WojtaCZ/repeat-hw/README.md

# REPEAT-HW

A repository containing hardware files (KiCad project) for the REPEAT board
