WojtaCZ/repeat-hw/repeat-hw.kicad_pcb

## KiCad design repeat-hw.kicad_pcb (2023-11-19)

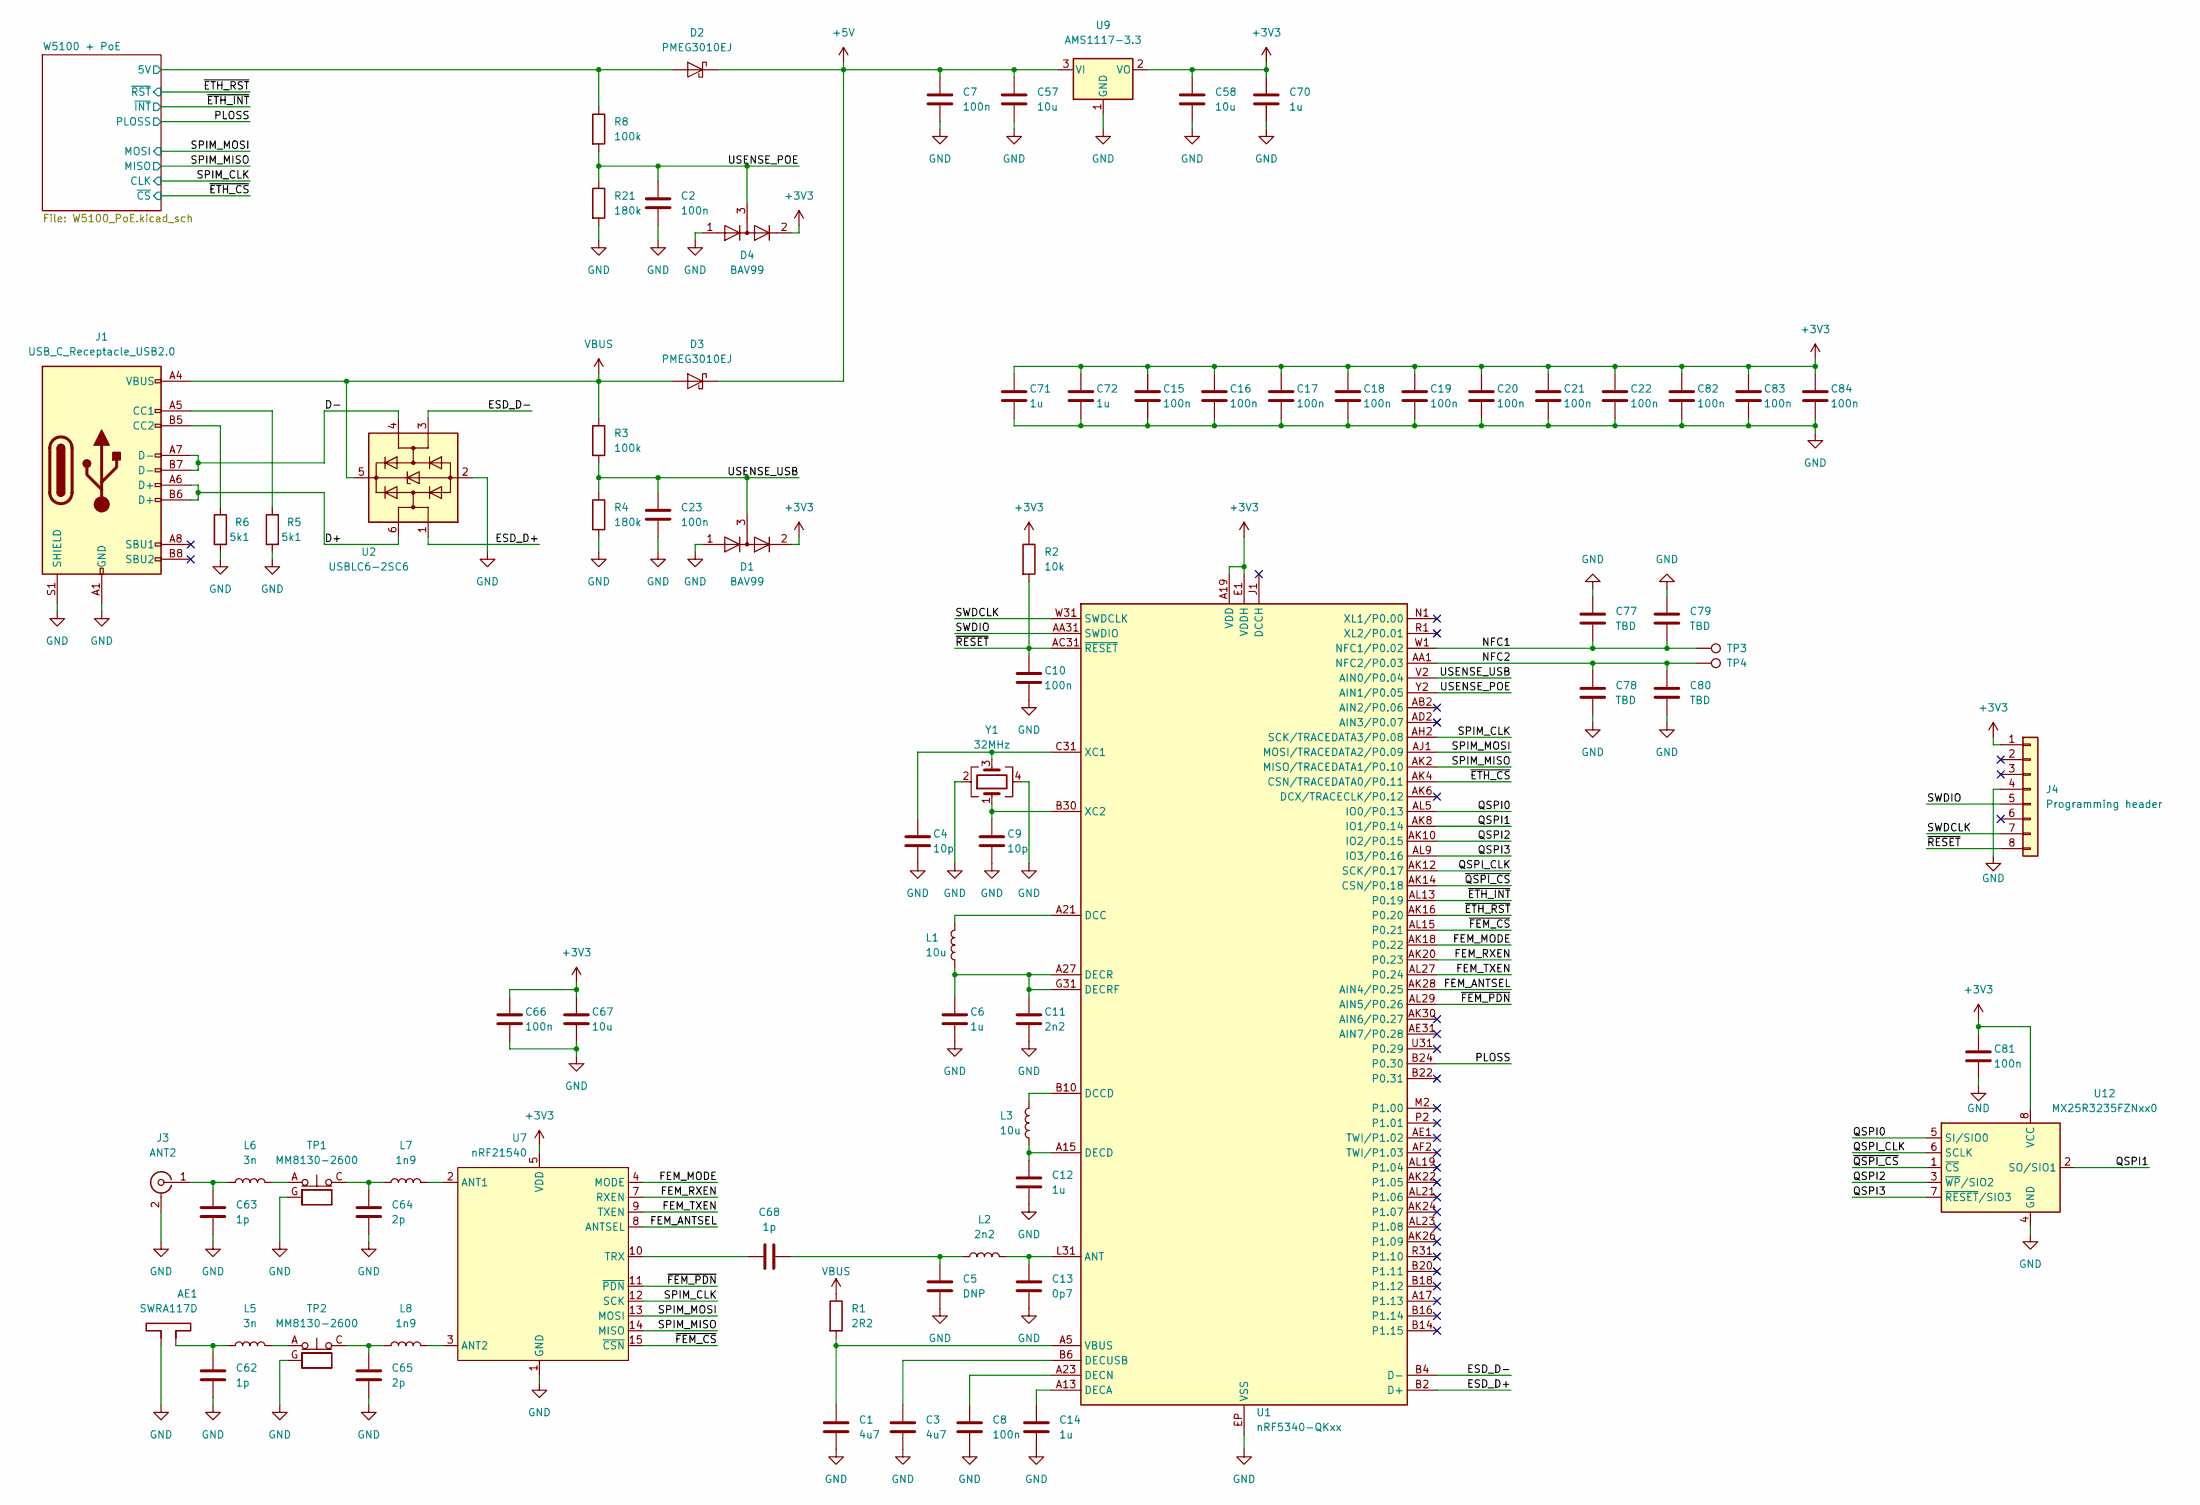
[picture p1: schematic repeat-hw.kicad_sch]

Parts:
AE1: SWRA117D; Texas_SWRA117D_2.4GHz_Right
C1, C3: 4u7; C_0603_1608Metric
C2, C7, C8, C10, C15, C16, C17, C18, C19, C20, C21, C22, C23, C66, C81, C82, C83, C84: 100n; C_0402_1005Metric
C4, C9: 10p; C_0402_1005Metric
C5: DNP; C_0402_1005Metric
C6, C12, C14, C70, C71, C72: 1u; C_0603_1608Metric
C11: 2n2; C_0402_1005Metric
C13: 0p7; C_0402_1005Metric
C57, C58: 10u; C_0603_1608Metric
C62, C63, C68: 1p; C_0402_1005Metric
C64, C65: 2p; C_0402_1005Metric
C67: 10u; C_0402_1005Metric
C77, C78, C79, C80: TBD; C_0402_1005Metric
D1, D4: BAV99; SOT-23
D2, D3: PMEG3010EJ; D_SOD-323F
J1: USB_C_Receptacle_USB2.0; USB_C_Receptacle_XKB_U262-16XN-4BVC11
J3: ANT2; U.FL_Hirose_U.FL-R-SMT-1_Vertical
J4: Programming header; SOIC_clipProgSmall
L1, L3: 10u; L_0603_1608Metric
L2: 2n2; C_0402_1005Metric
L5, L6: 3n; C_0402_1005Metric
L7, L8: 1n9; C_0402_1005Metric
R1: 2R2; R_0402_1005Metric
R2: 10k; R_0402_1005Metric
R3, R8: 100k; R_0402_1005Metric
R4, R21: 180k; R_0402_1005Metric
R5, R6: 5k1; R_0402_1005Metric
TP1, TP2: MM8130-2600
TP3, TP4: TestPoint; TestPoint_Pad_D1.0mm
U1: nRF5340-QKxx; Nordic_AQFN-94-1EP_7x7mm_P0.4mm
U2: USBLC6-2SC6; SOT-23-6
U7: nRF21540; QFN-16-1EP_4x4mm_P0.65mm_EP2.7x2.7mm_ThermalVias
U9: AMS1117-3.3; SOT-223-3_TabPin2
U12: MX25R3235FZNxx0; WSON-8-1EP_6x5mm_P1.27mm_EP3.4x4mm
Y1: 32MHz; Crystal_SMD_3225-4Pin_3.2x2.5mm

Connections:
+3V3: C15.1, C16.1, C17.1, C18.1, C19.1, C20.1, C21.1, C22.1, C58.1, C66.1, C67.1, C70.1, C71.1, C72.1, C81.1, C82.1, C83.1, C84.1, D1.2 (A), D4.2 (A), J4.1, R2.1, U1.A19 (VDD), U1.AC1 (VDD), U1.AG1 (VDD), U1.AJ31 (VDD), U1.AL3 (VDD), U1.AL7 (VDD), U1.AL11 (VDD), U1.AL17 (VDD), U1.AL25 (VDD), U1.B8 (VDD), U1.B28 (VDD), U1.C1 (VDD), U1.E1 (VDDH), U1.E31 (VDD), U1.L1 (VDD), U1.N31 (VDD), U1.U1 (VDD), U7.5 (VDD), U7.6 (VDD), U9.2 (VO), U12.8 (VCC); also elsewhere on the board
+5V: C7.1, C57.1, D2.1 (K), D3.1 (K), U9.3 (VI)
/D+: J1.A6 (D+), J1.B6 (D+), U2.6 (I/O1)
/D-: J1.A7 (D-), J1.B7 (D-), U2.4 (I/O2)
/ESD_D+: U1.B2 (D+), U2.1 (I/O1)
/ESD_D-: U1.B4 (D-), U2.3 (I/O2)
/FEM_ANTSEL: U1.AK28 (AIN4/P0.25), U7.8 (ANTSEL)
/FEM_MODE: U1.AK18 (P0.22), U7.4 (MODE)
/FEM_RXEN: U1.AK20 (P0.23), U7.7 (RXEN)
/FEM_TXEN: U1.AL27 (P0.24), U7.9 (TXEN)
/NFC1: C77.2, C79.2, TP3.1, U1.W1 (NFC1/P0.02)
/NFC2: C78.1, C80.1, TP4.1, U1.AA1 (NFC2/P0.03)
/PLOSS: U1.B24 (P0.30); also elsewhere on the board
/QSPI0: U1.AL5 (IO0/P0.13), U12.5 (SI/SIO0)
/QSPI1: U1.AK8 (IO1/P0.14), U12.2 (SO/SIO1)
/QSPI2: U1.AK10 (IO2/P0.15), U12.3 (~WP/SIO2)
/QSPI3: U1.AL9 (IO3/P0.16), U12.7 (~RESET/SIO3)
/QSPI_CLK: U1.AK12 (SCK/P0.17), U12.6 (SCLK)
/SPIM_CLK: U1.AH2 (SCK/TRACEDATA3/P0.08), U7.12 (SCK); also elsewhere on the board
/SPIM_MISO: U1.AK2 (MISO/TRACEDATA1/P0.10), U7.14 (MISO); also elsewhere on the board
/SPIM_MOSI: U1.AJ1 (MOSI/TRACEDATA2/P0.09), U7.13 (MOSI); also elsewhere on the board
/SWDCLK: J4.7, U1.W31 (SWDCLK)
/SWDIO: J4.5, U1.AA31 (SWDIO)
/USENSE_POE: C2.1, D4.3 (K), R8.2, R21.1, U1.Y2 (AIN1/P0.05)
/USENSE_USB: C23.1, D1.3 (K), R3.2, R4.1, U1.V2 (AIN0/P0.04)
/W5100 + PoE/5V: D2.2 (A), R8.1; also elsewhere on the board
/~ETH_CS: U1.AK4 (CSN/TRACEDATA0/P0.11); also elsewhere on the board
/~ETH_INT: U1.AL13 (P0.19); also elsewhere on the board
/~ETH_RST: U1.AK16 (P0.20); also elsewhere on the board
/~FEM_CS: U1.AL15 (P0.21), U7.15 (~CSN)
/~FEM_PDN: U1.AL29 (AIN5/P0.26), U7.11 (~PDN)
/~QSPI_CS: U1.AK14 (CSN/P0.18), U12.1 (~CS)
/~RESET: C10.1, J4.8, R2.2, U1.AC31 (~RESET)
GND: AE1.2, C1.2, C2.2, C3.2, C4.2, C5.2, C6.2, C7.2, C8.2, C9.2, C10.2, C11.2, C12.2, C13.2, C14.2, C15.2, C16.2, C17.2, C18.2, C19.2, C20.2, C21.2, C22.2, C23.2, C57.2, C58.2, C62.2, C63.2, C64.2, C65.2, C66.2, C67.2, C70.2, C71.2, C72.2, C77.1, C78.2, C79.1, C80.2, C81.2, C82.2, C83.2, C84.2, D1.1 (K), D4.1 (K), J1.A1 (GND), J1.A12 (GND), J1.B1 (GND), J1.B12 (GND), J1.S1 (SHIELD), J3.2 (Ext), J4.4, R4.2, R5.2, R6.2, R21.2, TP1.G, TP2.G, U1.EP (VSS), U2.2 (GND), U7.1 (GND), U7.16 (GND), U7.17 (GND), U9.1 (GND), U12.4 (GND), U12.9 (GND), Y1.2, Y1.4; also elsewhere on the board
unnamed: AE1.1, C62.1, L5.1
unnamed: C1.1, R1.2, U1.A5 (VBUS)
unnamed: C3.1, U1.B6 (DECUSB)
unnamed: C4.1, U1.C31 (XC1), Y1.3
unnamed: C5.1, C68.2, L2.1
unnamed: C8.1, U1.A23 (DECN)
unnamed: C9.1, U1.B30 (XC2), Y1.1
unnamed: C6.1, C11.1, L1.1, U1.A27 (DECR), U1.G31 (DECRF)
unnamed: C12.1, L3.1, U1.A15 (DECD)
unnamed: C13.1, L2.2, U1.L31 (ANT)
unnamed: C14.1, U1.A13 (DECA)
unnamed: C63.1, J3.1 (In), L6.1
unnamed: C64.1, L7.1, TP1.C
unnamed: C65.1, L8.1, TP2.C
unnamed: C68.1, U7.10 (TRX)
unnamed: J1.A5 (CC1), R5.1
unnamed: J1.B5 (CC2), R6.1
unnamed: L1.2, U1.A21 (DCC)
unnamed: L3.2, U1.B10 (DCCD)
unnamed: L5.2, TP2.A
unnamed: L6.2, TP1.A
unnamed: L7.2, U7.2 (ANT1)
unnamed: L8.2, U7.3 (ANT2)
VBUS: D3.2 (A), J1.A4 (VBUS), J1.A9 (VBUS), J1.B4 (VBUS), J1.B9 (VBUS), R1.1, R3.1, U2.5 (VBUS)

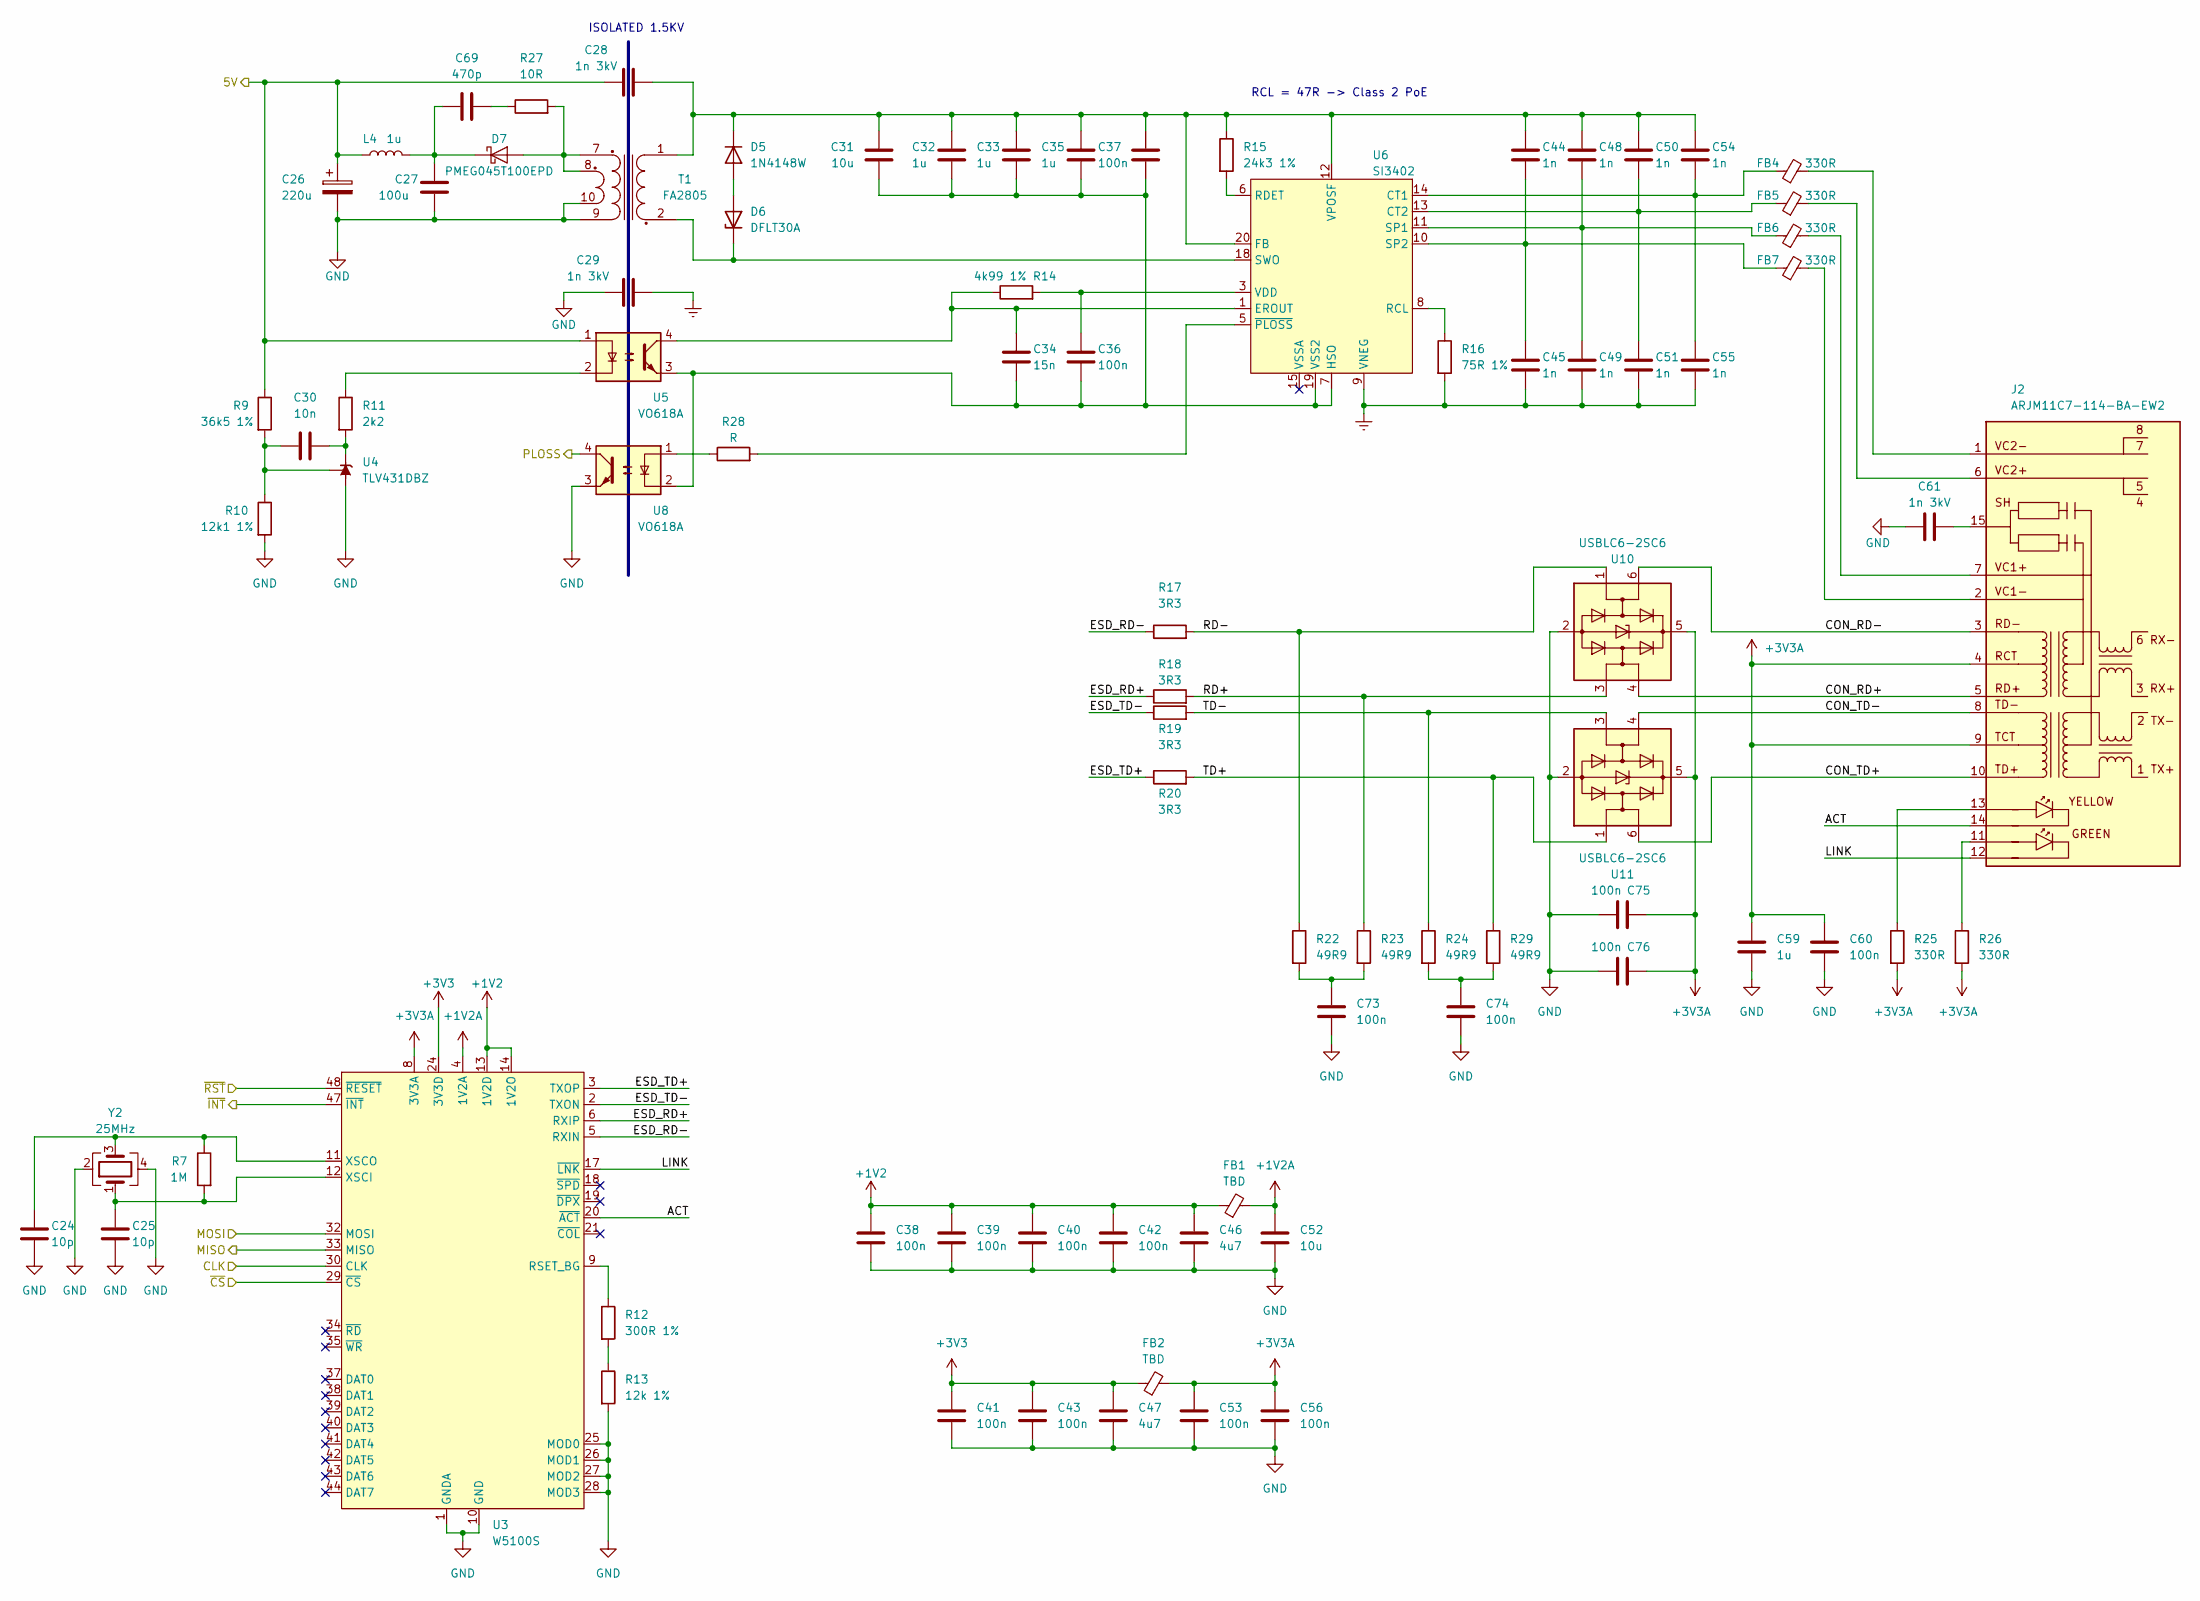
[picture p2: schematic W5100_PoE.kicad_sch]

Parts:
C24, C25: 10p; C_0402_1005Metric
C26: 220u; CP_Elec_5x5.3
C27: 100u; C_1206_3216Metric
C28, C29, C61: 1n 3kV; C_1206_3216Metric
C30: 10n; C_0402_1005Metric
C31, C52: 10u; C_0603_1608Metric
C32, C33, C35, C59: 1u; C_0603_1608Metric
C34: 15n; C_0402_1005Metric
C36, C37, C38, C39, C40, C41, C42, C43, C53, C56, C60, C73, C74, C75, C76: 100n; C_0402_1005Metric
C44, C45, C48, C49, C50, C51, C54, C55: 1n; C_0402_1005Metric
C46, C47: 4u7; C_0603_1608Metric
C69: 470p; C_0402_1005Metric
D5: 1N4148W; D_SOD-123
D6: DFLT30A; D_PowerDI-123
D7: PMEG045T100EPD; Nexperia_CFP15_SOT-1289
FB1, FB2: TBD; C_0402_1005Metric
FB4, FB5, FB6, FB7: 330R; L_0805_2012Metric
J2: ARJM11C7-114-BA-EW2
L4: 1u; C_0603_1608Metric
R7: 1M; R_0402_1005Metric
R9: 36k5 1%; R_0402_1005Metric
R10: 12k1 1%; R_0402_1005Metric
R11: 2k2; R_0402_1005Metric
R12: 300R 1%; R_0402_1005Metric
R13: 12k 1%; R_0402_1005Metric
R14: 4k99 1%; R_0402_1005Metric
R15: 24k3 1%; R_0402_1005Metric
R16: 75R 1%; R_0402_1005Metric
R17, R18, R19, R20: 3R3; R_0402_1005Metric
R22, R23, R24, R29: 49R9; R_0402_1005Metric
R25, R26: 330R; R_0402_1005Metric
R27: 10R; R_0402_1005Metric
R28: R; R_0402_1005Metric
T1: FA2805; Transformer_Coilcraft_Si3402
U3: W5100S; QFN-48-1EP_7x7mm_P0.5mm_EP5.3x5.3mm
U4: TLV431DBZ; SOT-23
U5, U8: VO618A; SO-4_7.6x3.6mm_P2.54mm
U6: SI3402; Skyworks_QFN-20_1EP5x5mm_P0.8mm_EP2.7x2.7mm
U10, U11: USBLC6-2SC6; SOT-23-6
Y2: 25MHz; Crystal_SMD_3225-4Pin_3.2x2.5mm

Connections:
+1V2: C38.1, C39.1, C40.1, C42.1, C46.1, FB1.1, U3.13 (1V2D), U3.14 (1V2O), U3.22 (1V2D), U3.31 (1V2D), U3.45 (1V2D)
+1V2A: C52.1, FB1.2, U3.4 (1V2A)
+3V3: C41.1, C43.1, C47.1, FB2.1, U3.24 (3V3D), U3.36 (3V3D); also elsewhere on the board
+3V3A: C53.1, C56.1, C59.1, C60.1, C75.2, C76.2, FB2.2, J2.4, J2.9, R25.2, R26.2, U3.8 (3V3A), U3.15 (3V3A), U10.5 (VBUS), U11.5 (VBUS)
/PLOSS: U8.4; also elsewhere on the board
/SPIM_CLK: U3.30 (CLK); also elsewhere on the board
/SPIM_MISO: U3.33 (MISO); also elsewhere on the board
/SPIM_MOSI: U3.32 (MOSI); also elsewhere on the board
/W5100 + PoE/5V: C26.1, C28.1, L4.1, R9.1, U5.1; also elsewhere on the board
/W5100 + PoE/ACT: J2.14, U3.20 (~ACT)
/W5100 + PoE/CON_RD+: J2.5, U10.4 (I/O2)
/W5100 + PoE/CON_RD-: J2.3, U10.6 (I/O1)
/W5100 + PoE/CON_TD+: J2.10, U11.6 (I/O1)
/W5100 + PoE/CON_TD-: J2.8, U11.4 (I/O2)
/W5100 + PoE/ESD_RD+: R18.1, U3.6 (RXIP)
/W5100 + PoE/ESD_RD-: R17.1, U3.5 (RXIN)
/W5100 + PoE/ESD_TD+: R20.1, U3.3 (TXOP)
/W5100 + PoE/ESD_TD-: R19.1, U3.2 (TXON)
/W5100 + PoE/LINK: J2.12, U3.17 (~LNK)
/W5100 + PoE/RD+: R18.2, R23.1, U10.3 (I/O2)
/W5100 + PoE/RD-: R17.2, R22.1, U10.1 (I/O1)
/W5100 + PoE/TD+: R20.2, R29.1, U11.1 (I/O1)
/W5100 + PoE/TD-: R19.2, R24.1, U11.3 (I/O2)
/~ETH_CS: U3.29 (~CS); also elsewhere on the board
/~ETH_INT: U3.47 (~INT); also elsewhere on the board
/~ETH_RST: U3.48 (~RESET); also elsewhere on the board
Earth: C29.2, C45.2, C49.2, C51.2, C55.2, R16.2, U6.9 (VNEG), U6.21 (VNEG)
GND: C24.2, C25.2, C26.2, C27.2, C29.1, C38.2, C39.2, C40.2, C41.2, C42.2, C43.2, C46.2, C47.2, C52.2, C53.2, C56.2, C59.2, C60.2, C61.1, C73.2, C74.2, C75.1, C76.1, R10.2, R13.2, T1.9, T1.10, U3.1 (GNDA), U3.7 (GNDA), U3.10 (GND), U3.16 (GNDA), U3.23 (GND), U3.25 (MOD0), U3.26 (MOD1), U3.27 (MOD2), U3.28 (MOD3), U3.46 (GND), U3.49 (GND), U4.3 (A), U8.3, U10.2 (GND), U11.2 (GND), Y2.2, Y2.4; also elsewhere on the board
unnamed: C24.1, R7.1, U3.11 (XSCO), Y2.3
unnamed: C25.1, R7.2, U3.12 (XSCI), Y2.1
unnamed: C27.1, C69.1, D7.3 (K), L4.2
unnamed: C28.2, C31.1, C32.1, C33.1, C35.1, C37.1, C44.1, C48.1, C50.1, C54.1, D5.1 (K), R15.1, T1.1, U6.12 (VPOSF), U6.20 (FB)
unnamed: C30.1, R9.2, R10.1, U4.2 (REF)
unnamed: C30.2, R11.2, U4.1 (K)
unnamed: C31.2, C32.2, C33.2, C34.2, C35.2, C36.2, C37.2, U5.3, U6.7 (HSO), U6.19 (VSS2), U8.2
unnamed: C34.1, R14.1, U5.4, U6.1 (EROUT)
unnamed: C36.1, R14.2, U6.3 (VDD)
unnamed: C44.2, C45.1, FB7.1, U6.10 (SP2)
unnamed: C48.2, C49.1, FB6.1, U6.11 (SP1)
unnamed: C50.2, C51.1, FB5.1, U6.13 (CT2)
unnamed: C54.2, C55.1, FB4.1, U6.14 (CT1)
unnamed: C61.2, J2.15
unnamed: C69.2, R27.1
unnamed: C73.1, R22.2, R23.2
unnamed: C74.1, R24.2, R29.2
unnamed: D5.2 (A), D6.2 (A)
unnamed: D6.1 (K), T1.2, U6.18 (SWO)
unnamed: D7.1 (A), D7.2 (A), R27.2, T1.7, T1.8
unnamed: FB4.2, J2.1
unnamed: FB5.2, J2.6
unnamed: FB6.2, J2.7
unnamed: FB7.2, J2.2
unnamed: J2.11, R26.1
unnamed: J2.13, R25.1
unnamed: R11.1, U5.2
unnamed: R12.1, U3.9 (RSET_BG)
unnamed: R12.2, R13.1
unnamed: R15.2, U6.6 (RDET)
unnamed: R16.1, U6.8 (RCL)
unnamed: R28.1, U8.1
unnamed: R28.2, U6.5 (~PLOSS)

Notes on the sheet:
ISOLATED 1.5KV
RCL = 47R -> Class 2 PoE

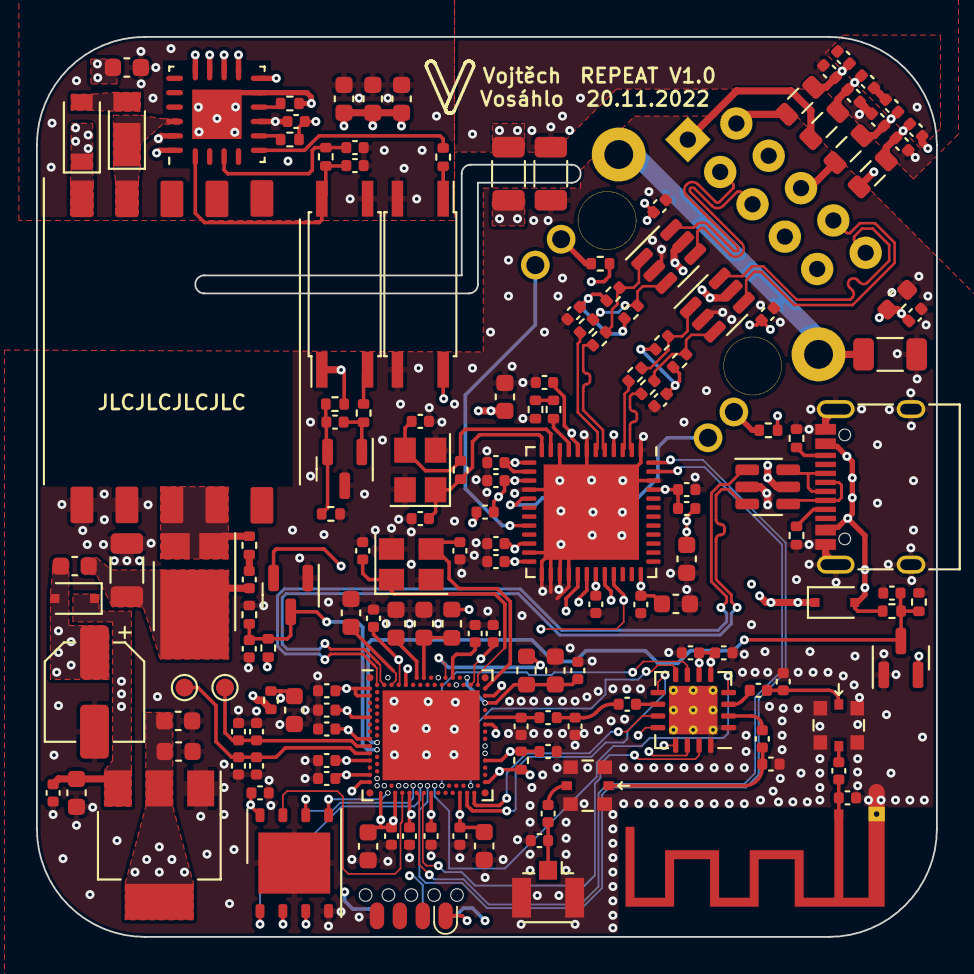
[picture p3: board repeat-hw.kicad_pcb from above]

Board: 6 copper layers, 50.0 x 50.0 mm, 158 parts (1 on the bottom side), 109 nets.
