WojtaCZ/repeat-hw/(commit log)

2022-10-17 added W5100
    [W5100.kicad_sch, mcu.kicad_sch, repeat-hw.kicad_pcb, repeat-hw.kicad_sch]
2022-10-17 Added RJ45
    [W5100.kicad_sch, repeat-hw.kicad_sch]
2022-10-23 Finishe PoE and ethernet
    [W5100.kicad_sch, mcu.kicad_sch, repeat-hw.kicad_pcb, repeat-hw.kicad_sch]
2022-10-25 Added USB port
    [W5100.kicad_sch, mcu.kicad_sch, repeat-hw.kicad_pcb, repeat-hw.kicad_sch]
2022-10-26 Polished schematic
    [W5100_PoE.kicad_sch, repeat-hw.kicad_pcb, repeat-hw.kicad_sch]
2022-10-26 Hopefully finished schematic
    [W5100_PoE.kicad_sch, repeat-hw.kicad_sch]
2022-11-19 Routing half done
    [repeat-hw.kicad_pcb, repeat-hw.kicad_sch]
2022-11-19 More routing
    [repeat-hw.kicad_pcb]
2022-11-20 Routing almost done
    [W5100_PoE.kicad_sch, repeat-hw.kicad_pcb]
2022-11-20 Routing done
    [W5100_PoE.kicad_sch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]
2022-11-20 Updated schematic
2022-11-24 Finalized for production
    [repeat-hw-B_Cu.gbl, repeat-hw-B_Cu.gbr, repeat-hw-B_Mask.gbs, repeat-hw-B_Paste.gbp, repeat-hw-B_Paste.gbr, repeat-hw-B_Silkscreen.gbo, repeat-hw-B_Silkscreen.gbr, repeat-hw-Edge_Cuts.gbr]
2022-11-26 Changed via to copper clearance to correct value
    [W5100_PoE.kicad_sch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]
2023-11-19 Clean up
    [repeat-hw-BOM-ceny.ods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]
